lucasl0st/3d_models/nikon_ai_conversion-20mm_3-5_ud/README.md

# Nikon 20mm f3.5 UD Auto AI Conversion

This part is meant as a replacement for the Nikon AI conversion kit part B number 20.

This part is for serial numbers `432211` and higher, lower serial numbers use a different part number,
so they are likely incompatible with this conversion. My lens has the serial number `475000`.  
My information source about AI conversions: [http://www.photosynthesis.co.nz/nikon/aimod.html](http://www.photosynthesis.co.nz/nikon/aimod.html)

This modification does not alter the lens and is completely reversible.

## Printing

The provided STL is ready for print without further modifications, I printed using standard PLA
on a Neptune 4 3D printer and OrcaSlicer.

The aperture letters are small, on most if not all printers they will look ugly, if you don't want them
you can disable them in the provided SCAD source file.

There are also further customization options available in the OpenSCAD file:

- Prong holes for compatibility with Nikon F1/F2 meters
- Declicking for smooth aperture selection (ideal for video applications)
- Enable/Disable grip or grip rills
- Enable/Disable aperture letters (upper and lower separately)

## Installation

> [!WARNING]  
> Be careful with your screwdriver! Do not apply too much pressure, otherwise you might slip and scratch the lens!

The installation is quite easy on this lens.
I recommend to set the aperture to f3.5 before starting, it will make lining up the new aperture control ring later easier.

### Remove lens mount

Remove the 5 screws of the lens mount, grab the lens mount and put it aside:

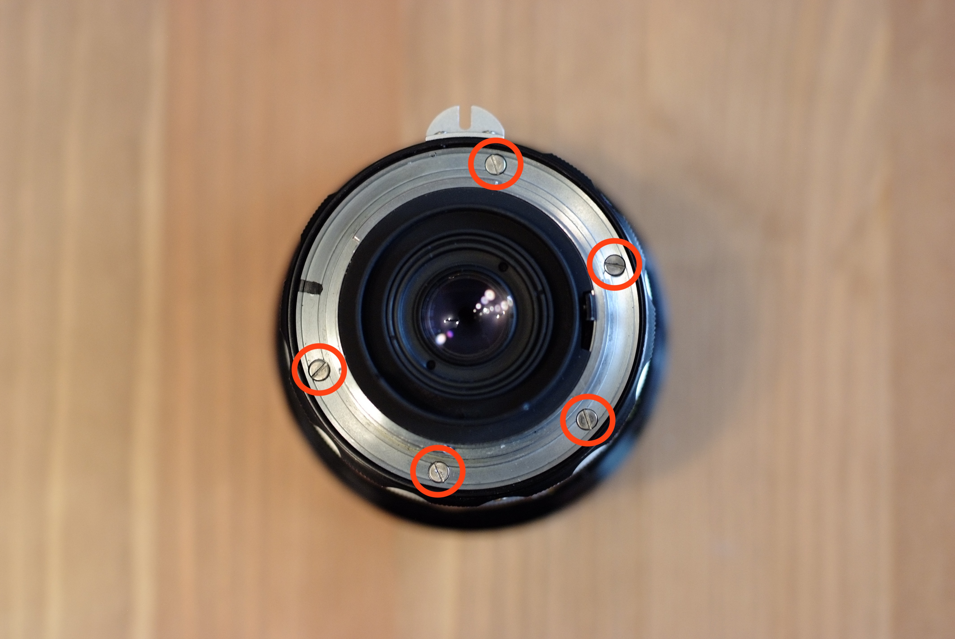
[picture p1: nikon_ai_conversion-20mm_3-5_ud/assets/lens_mount_remove.jpeg]
remove lens mount


### Remove aperture control screw

Remove the aperture control screw and remove the aperture control ring.
Store the ring somewhere safely if you want to reverse the modification.

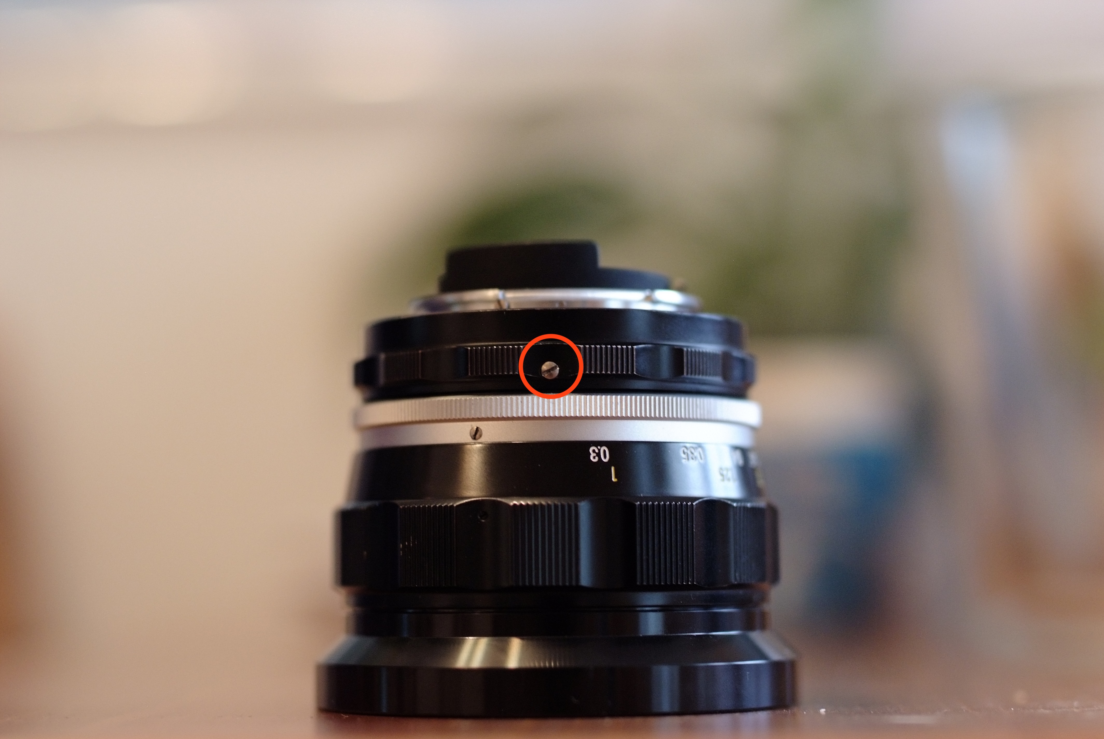
[picture p2: nikon_ai_conversion-20mm_3-5_ud/assets/remove_aperture_control_ring.jpeg]
remove aperture control ring


### Insert new aperture control ring

Place your new aperture control ring onto the lens, ensure it is set to f3.5
Also ensure that the matching hole on the lens for the aperture control screw is lined up with the control ring hole.
Then screw in the aperture control screw. The hole in the new ring is intentionally smaller, you will need to forcefully
thread it.

### Re-attach lens mount

Place the lens mount on the lens ensuring that the aperture spring lever is lined up,
line up the screws and screw everything back together.

### Check and validate

You are now done! Check if you can control the aperture with the new aperture ring.
Then you can mount the lens on your camera. If set to f3.5 the aperture index should touch the camera
aperture feeler, but it should not move it.

lens mounted
