lucasl0st/3d_models/nikon_ai_conversion-20mm_3-5_ud/build/nikon_ai_conversion-20mm_3-5_ud.stl

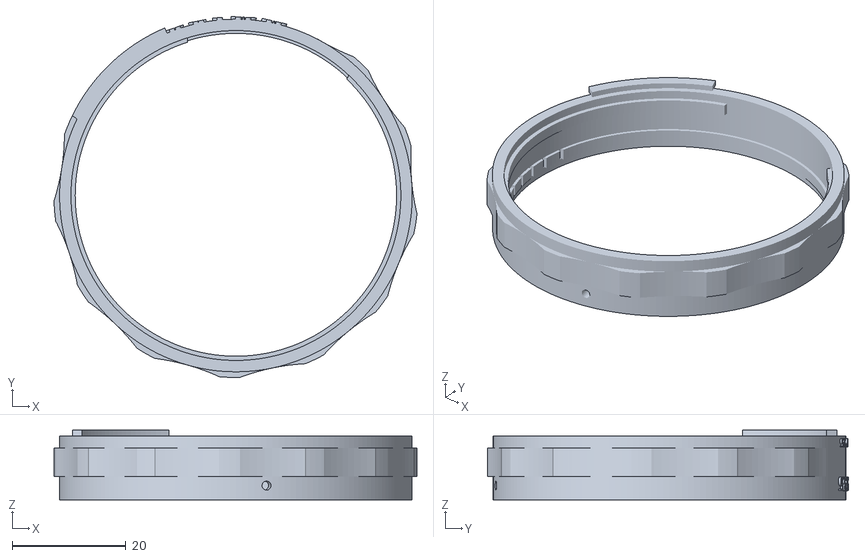
[picture p6: CAD file, 2025-10-21]
nikon_ai_conversion-20mm_3-5_ud/build/nikon_ai_conversion-20mm_3-5_ud.stl
63.8 x 63.5 x 12.2
