lucasl0st/3d_models/nikon_ai_conversion-55mm_1-2_auto/build/nikon_55mmf12_auto_ai_conversion_declicked.stl

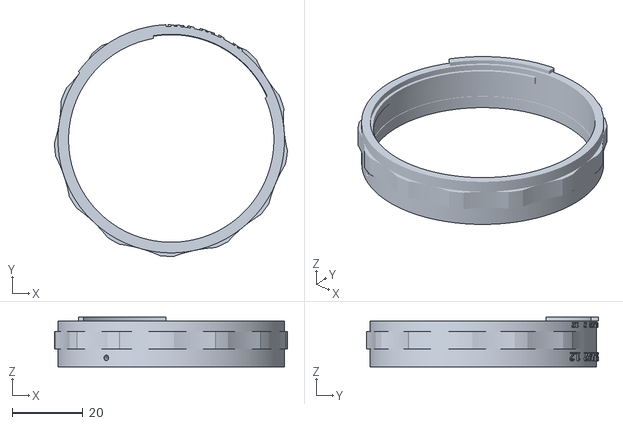
[picture p7: CAD file, 2025-05-29]
nikon_ai_conversion-55mm_1-2_auto/build/nikon_55mmf12_auto_ai_conversion_declicked.stl
65.8 x 65.5 x 14.0
