lucasl0st/3d_models/nikon_g_lens_ledge/build/nikon_g_lens-aperture-ledge-9mm.stl

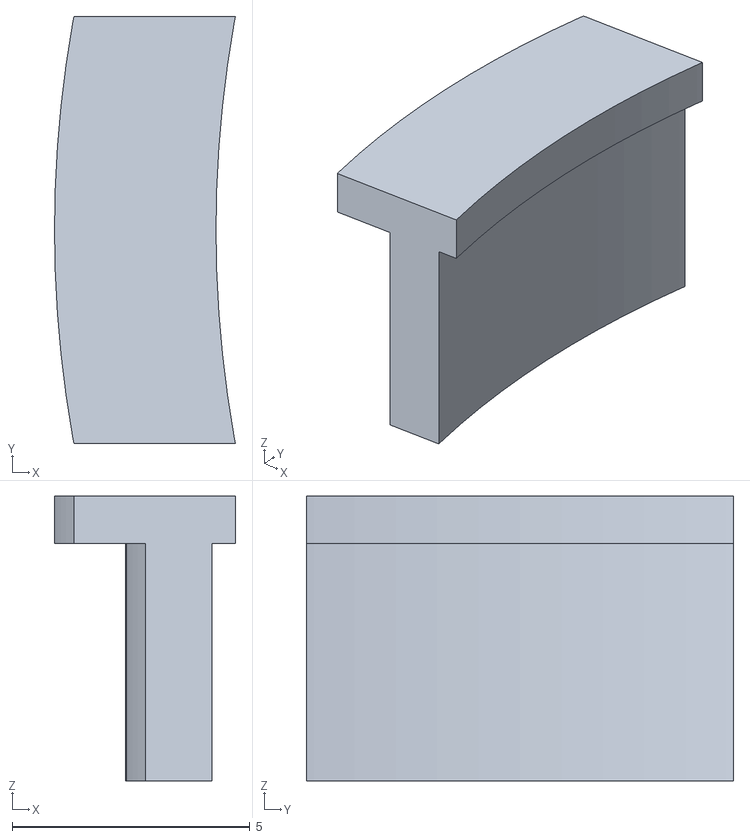
[picture p8: CAD file, 2025-05-24]
nikon_g_lens_ledge/build/nikon_g_lens-aperture-ledge-9mm.stl
3.81 x 9.00 x 6.00
