lucasl0st/3d_models/nikon_g_lens_ledge/build/nikon_g_lens-aperture-ledge-3mm.stl

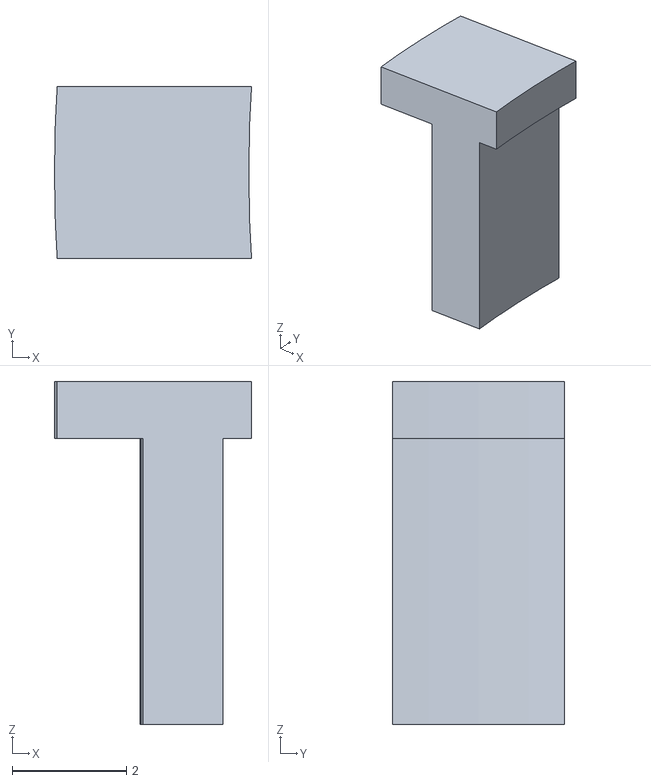
[picture p10: CAD file, 2025-05-24]
nikon_g_lens_ledge/build/nikon_g_lens-aperture-ledge-3mm.stl
3.45 x 3.00 x 6.00
