lucasl0st/3d_models/nikon_g_lens_ledge/build/nikon_g_lens-aperture-ledge-7mm.stl

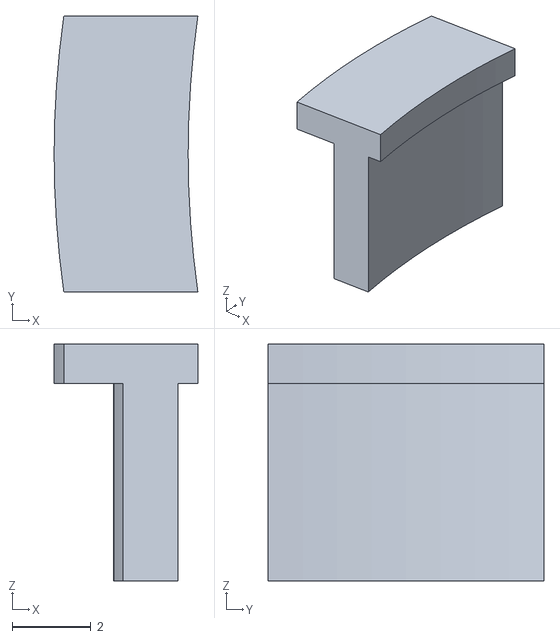
[picture p11: CAD file, 2025-05-24]
nikon_g_lens_ledge/build/nikon_g_lens-aperture-ledge-7mm.stl
3.65 x 7.00 x 6.00
