lucasl0st/3d_models/nikon_g_lens_ledge/build/nikon_g_lens-aperture-ledge-2mm.stl

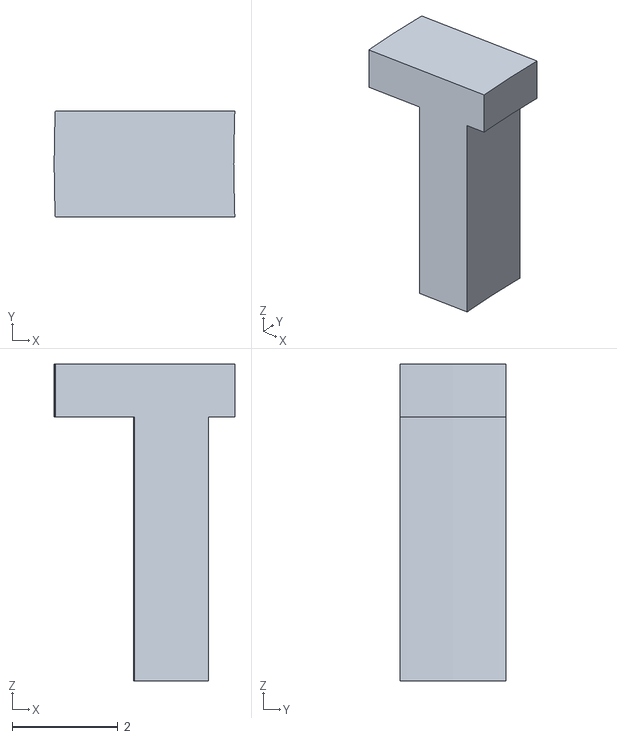
[picture p12: CAD file, 2025-05-24]
nikon_g_lens_ledge/build/nikon_g_lens-aperture-ledge-2mm.stl
3.42 x 2.00 x 6.00
