lucasl0st/3d_models/nikon_g_lens_ledge/build/nikon_g_lens-aperture-ledge-8mm.stl

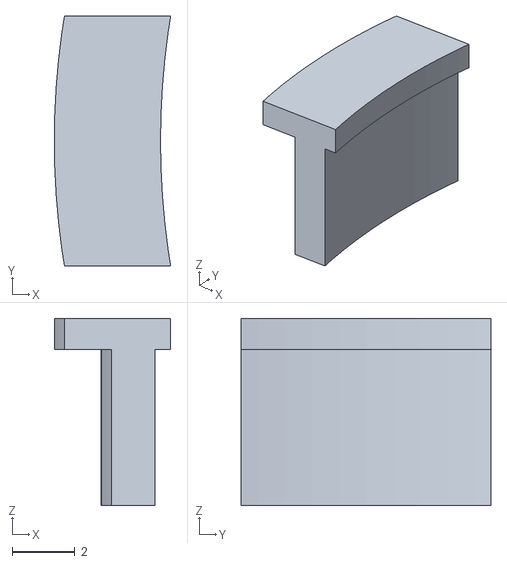
[picture p13: CAD file, 2025-05-24]
nikon_g_lens_ledge/build/nikon_g_lens-aperture-ledge-8mm.stl
3.73 x 8.00 x 6.00
