lucasl0st/3d_models/nikon_g_lens_ledge/build/nikon_g_lens-aperture-ledge-2_10mm.stl

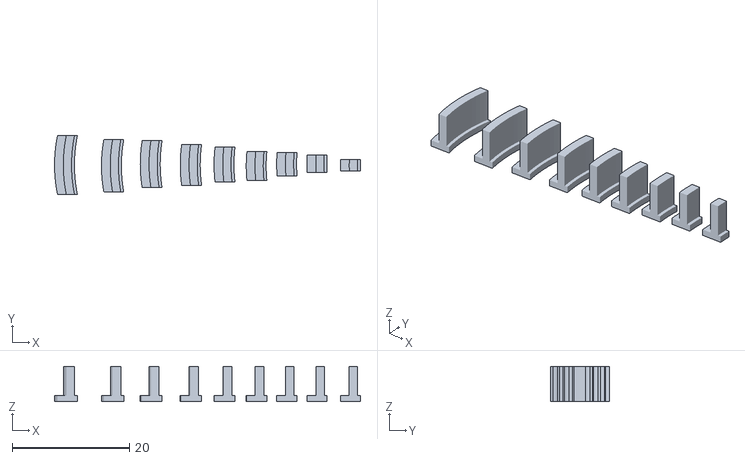
[picture p15: CAD file, 2025-05-24]
nikon_g_lens_ledge/build/nikon_g_lens-aperture-ledge-2_10mm.stl
52.1 x 10.0 x 6.00
