lucasl0st/3d_models/(list of files, cad)

Other CAD files:
nikon_ai_conversion-55mm_1-2_auto/src/nikon_55mmf12_auto_ai_conversion.scad
