lucasl0st/3d_models/(commit log)

2025-05-24 feat: add nikon g type lens ledge
    [nikon_g_lens-aperture-ledge-10mm.stl, nikon_g_lens-aperture-ledge-2_10mm.stl, nikon_g_lens-aperture-ledge-2mm.stl, nikon_g_lens-aperture-ledge-3mm.stl, nikon_g_lens-aperture-ledge-4mm.stl, nikon_g_lens-aperture-ledge-5mm.stl, nikon_g_lens-aperture-ledge-6mm.stl, nikon_g_lens-aperture-ledge-7mm.stl]
2025-05-24 feat: add nikon 55mm f1.4 AI conversion ring prototype
    [nikon_55mmf14_ai_conversion.scad]
2025-05-24 feat: add nikon 55mm f1.4 AI conversion ring prototype stl
    [nikon_55mmf14_ai_conversion.stl]
2025-05-24 feat(ai_conversion): add aperture letters and prongs
    [nikon_55mmf14_ai_conversion.scad, nikon_55mmf14_ai_conversion.stl]
2025-05-24 feat(ai_conversion): add grip
    [nikon_55mmf14_ai_conversion.scad, nikon_55mmf14_ai_conversion.stl]
2025-05-24 feat(ai_conversion): add rills to grip
    [nikon_55mmf14_ai_conversion.scad, nikon_55mmf14_ai_conversion.stl]
2025-05-25 feat(ai_conversion): add aperture click mechanism
    [nikon_55mmf14_ai_conversion.scad, nikon_55mmf14_ai_conversion.stl]
2025-05-29 feat(ai_conversion): add documentation
    [nikon_55mmf12_auto_ai_conversion.scad, nikon_55mmf12_auto_ai_conversion.stl, nikon_55mmf12_auto_ai_conversion_declicked.stl]
2025-10-12 feat: document 55mm 1.2 incompatibility
2025-10-21 feat: add nikon 20mm 3.5 UD ai conversion (#1)
    [nikon_ai_conversion-20mm_3-5_ud.scad, nikon_ai_conversion-20mm_3-5_ud.stl]
